Animan-AI/DuckBuddy/docs/media/arch-software-en.png

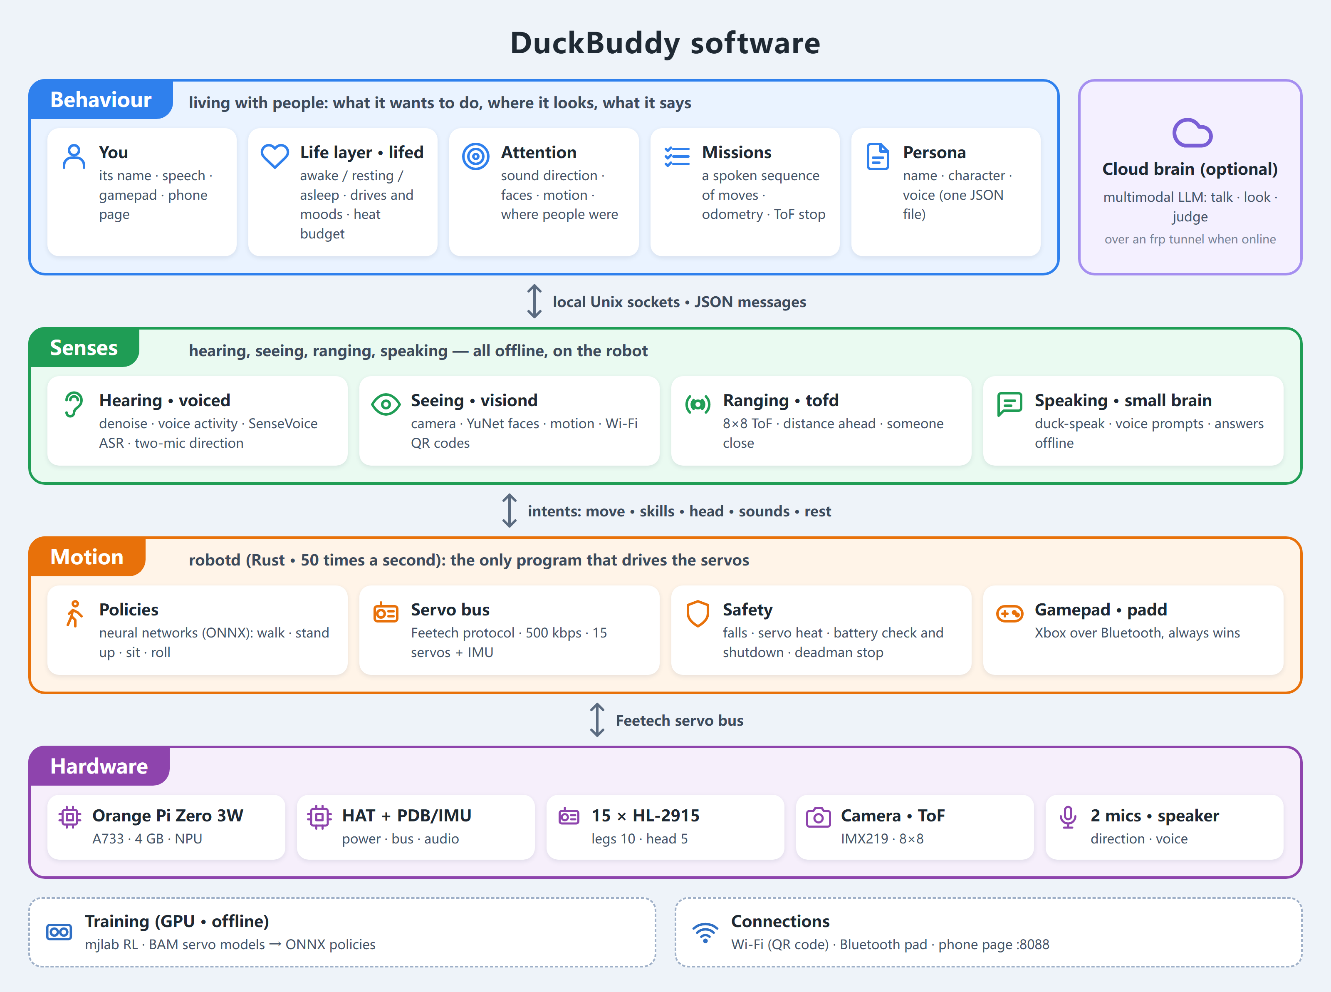
docs/media/arch-software-en.png
