Animan-AI/DuckBuddy/docs/media/boards-en.png

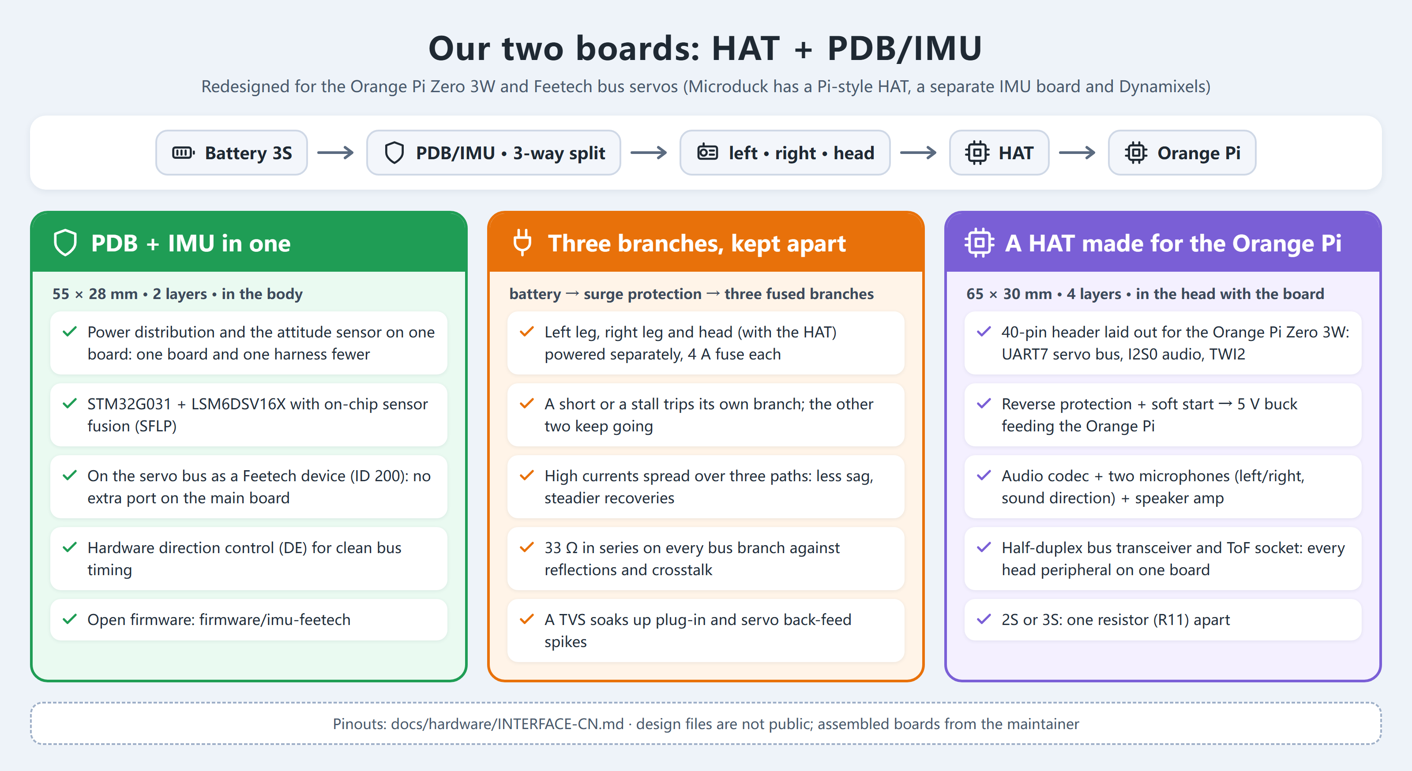
docs/media/boards-en.png
