Animan-AI/DuckBuddy/tools/joint_align/head-zero-vs-home.png

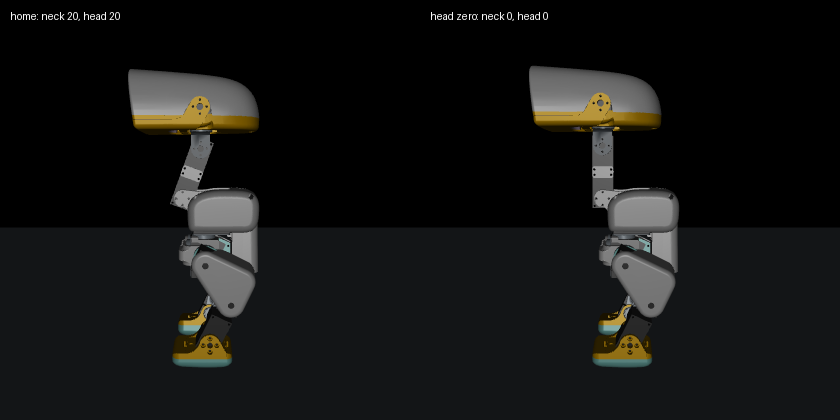
tools/joint_align/head-zero-vs-home.png
