Animan-AI/DuckBuddy/hardware/print/DuckBuddy_2915.3mf

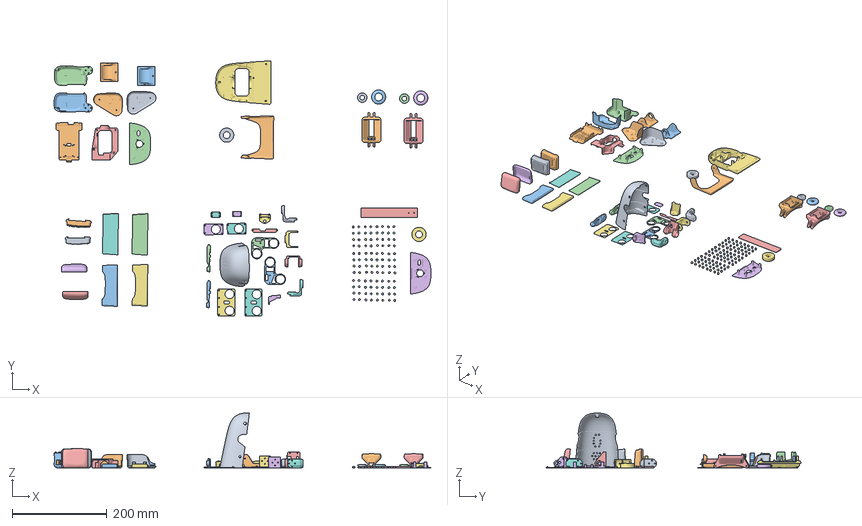
[picture p9: CAD file, 2026-11-07]
hardware/print/DuckBuddy_2915.3mf
795.9 x 538.9 x 116.1 mm
foot_left.stl
foot_right.stl
leg.stl
leg2.stl
banana_pcb_locker.stl
bearing_roll1.stl x 2
bottom_head_shell.stl
hip_l.stl
hip_l1.stl
jaw.stl
jaw_soft.stl x 2
left_shell.stl
motor_support.stl
neck.stl
neck_pitch.stl
neck1.stl
noenoeil.stl
power_support.stl
right_shell.stl
soft_mouth_top.stl x 2
sole_left.stl
sole_right.stl
trunk_base.stl
trunk_base1.stl
upper_leg_left.stl
upper_leg_right.stl
upper_leg_rigidity_plate.stl
upper_leg_rigidity_plate1.stl
yaw_roll_motion.stl
yaw2roll.stl
yaw2roll1.stl
rim_轮辋.stl x 2
roller_blade_滚轮叶片.stl x 2
tire_轮胎.stl x 2
top_head_shell.stl_Boolean_Boolean_Boolean_Boolean_Boolean_Boolean_Boolean_Boolean
ankle_right脚踝右.STEP
ankle_left_脚踝左.STEP
face_part.stl_Boolean
立方体_Boolean
face_part
noenoeil-
圆柱体 x 96
