Animan-AI/DuckBuddy/UPSTREAM-CHANGES.md

# Changes to Microduck

This project starts from Pollen Robotics' Microduck at commit `590b986bd8c0` (2026-08-27), Apache License 2.0. Every file below is a Microduck file this project has modified or removed; 724 files are new. The git history of the changes is kept by the maintainer.

## Modified (37)

- `.github/workflows/dev.yml`
- `.github/workflows/prune-dev-releases.yml`
- `btd/src/route.rs`
- `configd/src/net.rs`
- `configd/src/pad.rs`
- `deploy/audio/aic3104-init.sh`
- `deploy/robotd.toml`
- `docs/robot/cheatsheet.md`
- `duck-control/src/bus.rs`
- `duck-control/src/imu.rs`
- `duck-control/src/io.rs`
- `duck-control/src/lib.rs`
- `duck-control/src/model.rs`
- `duck-control/src/policy.rs`
- `duck-control/src/safety.rs`
- `duck-ipc-proto/src/lib.rs`
- `mediad/src/pipeline.rs`
- `mediad/src/route.rs`
- `padd/src/main.rs`
- `pet-detect/Cargo.toml`
- `pet-detect/src/lib.rs`
- `pet-detect/src/worker.rs`
- `robotctl/src/configure.rs`
- `robotctl/src/main.rs`
- `robotctl/src/monitor.rs`
- `robotd-params/src/lib.rs`
- `robotd-params/src/registry.rs`
- `robotd/src/control.rs`
- `robotd/src/intents.rs`
- `robotd/src/main.rs`
- `robotd/src/sound.rs`
- `sounds/src/lib.rs`
- `sounds/src/main.rs`
- `sounds/src/stream.rs`
- `updater/src/ipc.rs`
- `updater/src/robot.rs`
- `updater/src/source/mod.rs`

## Removed (0)
