Animan-AI/DuckBuddy/(commit log)

2026-10-18 Microduck Life: a Microduck-based biped with a life of its own
    Feetech HL-2915 servos, an Orange Pi Zero 3W (A733) with our HAT and PDB/IMU boards (interface
    documented, design files not included), policies retrained for the HL-2915, and an on-robot life
    layer: attention, voice, vision and missions.
    Built on Pollen Robotics' Microduck (Apache-2.0), commit 590b986; the Microduck files changed are
    listed in UPSTREAM-CHANGES.md. Not affiliated with Pollen Robotics.
2026-10-24 print: the Bambu project is now DuckBuddy.3mf, tidied into 6 plates (was microduck2.3mf, 9 plates)
2026-10-30 print: DuckBuddy.3mf updated - the reworked head top shell on plate 5, plate 6 now a BAM arm for servo identification
2026-11-03 tools/bringup: the bring-up workbench - servo IDs, joint mapping, zero calibration, IMU firmware and a whole-robot test in one web page
    joint_align gets the calibration the workbench embeds (signs / offsets read from and written back to the
    robot's config, fine-tuning on the home pose); duckcam finds the camera's node itself and takes --dev.
    README: building step 6.
2026-11-04 site: the project page on GitHub Pages - home, BOM and the newcomer tutorial
    site/build.py renders site/content into static pages with the pictures from docs/media;
    .github/workflows/pages.yml builds and deploys it on pushes to main.
2026-11-04 site: the image's Baidu Netdisk link; BOM: HAT-PDB is a PH2.0 3P cable, HL-2915 needs 3 PH1.25-AMP2.0 adapters (both come with the boards)
2026-11-04 site: assembly page for the two boards (PDB in the trunk, HAT + Orange Pi in the head) with photos; BOM: PDB screws, silicone rings, printed spacers, fan
2026-11-04 site: PDB's two large holes take 2.6x8x6 screws in silicone rings, the two small ones M1.8x8 over a printed washer; the PH2.0 3P HAT-PDB cable is bought separately
2026-11-04 README: links to the project page (BOM, assembly, getting started) and the system image under the badges
2026-11-04 site: HAT photo numbered by connector (fan, ToF, left/right mic, speaker, J2 to PDB), the table keyed to it; the fan plugs into HAT's top-left header
2026-11-07 Add HL-2915 and HD-1910 print projects
2026-11-07 Link both 3MF downloads from the BOM
